mireckazimir/room-monitor/README.md

# Room monitoring shield for Raspberry Pi Zero
Part of Master's thesis "Multisensor Module for Raspberry Pi Zero"

### <ins>Hardware design</ins>
PCB designed in Altium designer

### <ins>Software implementation</ins>
