mireckazimir/room-monitor/hardware/readme.md

## Multi-sensor module for Raspberry Pi Zero
RPi Zero shield containg multiple sensors:
- MQ2 (SEN-17049)
- VEML7700
- SPH0645LM4H-B (2 pcs)
- EKMC1691111

PCB designed in Altium Designer
