mireckazimir/room-monitor/hardware/RPiZeroShield/readme.txt

Multisenzorový modul pro Raspberry Pi Zero
Bc. Miroslav Kažimír (xkazim00)

Adresár RPiZeroShield obsahuje projekt programu Altium Designer.
Hlavným súborom projektu je RPiZeroShield.PrjPcb, ktorý otvára celý projekt.

Súčasťou projektu je:
- schéma Sheet1.SchDoc,
- návrh dosky plošných spojov PCB1.PcbDoc,
- knižnica schematických značiek súčiastok RPiZeroShield.SCHLIB,
- knižnica modelov a pôdorysov súčiastok pre dosku plošných spojov PCB1.PcbLib,
- súbor slúžiaci na export podkladov Job1.OutJob
- a ďalšie obslužné súbory.

Podadresár "Project Outputs for RPiZeroShield" obsahuje výstupné podklady:
- montážne nákresy,
- súbory Gerber,
- súbory NC Drill,
- 3D model vo formáte PDF,
- súbory pre strojové osadenie súčiastok Pick Place,
- schémy vo formáte PDF,
- zoznam použitých súčiastok (bill of materials - BOM),
- a ďalšie výstupné súbory.
