mireckazimir/room-monitor/hardware/RPiZeroShield/BOM_RPiZeroShield.xlsx

Sheet: BOM list
Poloha | I2C ADDR (7-bit) | Označenie | Súčiastka (Mfr. no.) | Model | LIB | Link | Mouser no. | Poznámka
Raspberry Pi Zero Shield
MIC | - | MIC1, MIC2 | SPH0645LM4H-B |  |  | https://www.mouser.sk/ProductDetail/Knowles/SPH0645LM4H-B?qs=vWxAESdW%252B03xAMCR63JEHA%3D%3D | 721-SPH0645LM4H-B
MIC |  | R1,R2,R3,R4 | ERJ-6ENF51R0V |  |  | https://www.mouser.sk/ProductDetail/Panasonic/ERJ-6ENF51R0V?qs=sGAEpiMZZMtlubZbdhIBIGigBIB3A6R9PKWYQsW5ZXE%3D | 667-ERJ-6ENF51R0V
MIC |  | C1, C2 | C1206C201F4HACTU |  |  | https://www.mouser.sk/ProductDetail/KEMET/C1206C201F4HACTU | 80-C1206C201F4HACTU
MIC, PIR, LIGHT, ADC |  | C3, C4, C5, C7, C9 | GRM3195C1H104GA05D |  |  | https://www.mouser.sk/ProductDetail/Murata-Electronics/GRM3195C1H104GA05D?qs=F5EMLAvA7ICo6gyPKpY%252BBA%3D%3D | 81-GRM3195C1H104GA5D
PIR | - | U1 | EKMC1609111 |  |  | https://www.mouser.sk/ProductDetail/Panasonic-Industrial-Devices/EKMC1609111?qs=zW32dvEIR3uDXIrRofIryw%3D%3D | 769-EKMC1609111 | V schéme je EKMC1603111 - footprint totožný s EKMC1609111, iba 3D model sa jemne líši
PIR |  | C6 | ECE-A0JKS101B | EPW |  | https://www.mouser.sk/ProductDetail/Panasonic/ECE-A0JKS101B | 667-ECE-A0JKS101B
PIR |  | R5 | RC1206FR-07100KL |  |  | https://www.mouser.sk/ProductDetail/YAGEO/RC1206FR-07100KL?qs=sGAEpiMZZMtlubZbdhIBINNnCgAqWV6vON6Wzl3HpWU%3D | 603-RC1206FR-07100KL | Pull-down (možno ani nebude potrebné ho osádzať)
GAS SENSOR | - | U2 | SEN-17049 |  |  | https://www.mouser.sk/ProductDetail/SparkFun/SEN-17049 | 474-SEN-17049 | MQ2 senzor
GAS SENSOR |  | R6 | RCC12064K70FKEA |  |  | https://www.mouser.sk/ProductDetail/Vishay-Dale/RCC12064K70FKEA?qs=IS%252B4QmGtzzqZHWR9BmF4GA%3D%3D | 71-RCC12064K70FKEA | R LOAD - podľa dokumentácie 4.7kOhm, pre prípad dávam väčší rozmer, aby bola možná výmena za rezistor s väčším odporom
GAS SENSOR |  | R7 | RC1206JR-7W2RL |  |  | https://www.mouser.sk/ProductDetail/YAGEO/RC1206JR-7W2RL?qs=tggtontpCXN8n0ANSq4Tow%3D%3D | 603-RC1206JR-7W2RL | R Heater
LIGHT SENSOR | 0010000 = 0x10 | U3 | VEML7700-TT | EPW |  | https://www.mouser.sk/ProductDetail/Vishay-Semiconductors/VEML7700-TT?qs=BcfjnG7NVaXdL6DJFdWbdw%3D%3D | 78-VEML7700-TT
I2C_LLC |  | U4 | PCA9306D,118 | EPW |  | https://www.mouser.sk/ProductDetail/NXP-Semiconductors/PCA9306D118?qs=LOCUfHb8d9tHesUGaH1D9A%3D%3D | 771-PCA9306D-T | Alternatíva: PCA9306DP,118
I2C_LLC |  | R8 | RCC1206200KFKEA | EPW |  | https://www.mouser.sk/ProductDetail/Vishay-Dale/RCC1206200KFKEA?qs=IS%252B4QmGtzzrN0pIOKXDpaA%3D%3D | 71-RCC1206200KFKEA
I2C_LLC |  | C8 | C0805C101F3HACTU |  |  | https://www.mouser.sk/ProductDetail/KEMET/C0805C101F3HACTU?qs=W0yvOO0ixfH%2FhL0iFC0bAg%3D%3D | 80-C0805C101F3HACTU
I2C_LLC |  | R9, R10, R11, R12 | RCC12062K20FKEA | EPW |  | https://www.mouser.sk/ProductDetail/Vishay-Dale/RCC12062K20FKEA | 71-RCC12062K20FKEA | 2.2k pull-up pre 5V + rezerva (R9, R10) pre 3.3V pre prípad použitia s inou doskou ako RPI
ADC | 1101001 = 0x69 | U5 | MCP3422A1-E/SN |  |  | https://www.mouser.sk/ProductDetail/Microchip-Technology/MCP3422A1-E-SN?qs=X98pPdo4MrvGixh6%2F80sIQ%3D%3D | 579-MCP3422A1-E/SN
ADC |  | C10 | T491A106K020AT |  |  | https://www.mouser.sk/ProductDetail/KEMET/T491A106K020AT?qs=sGAEpiMZZMtZ1n0r9vR22fi4xnbQCvTobjhiqE69rJs%3D | 80-T491A106K020AT | 10uF tantalum CAP
ADC |  | R13, R14 | ERJ-P06D6801V | EPW |  | https://www.mouser.sk/ProductDetail/Panasonic/ERJ-P06D6801V?qs=sGAEpiMZZMtlubZbdhIBIHf7nJ0gOzH3WYsUgpuEB4E%3D | 667-ERJ-P06D6801V | voltage divider
ADC, GPIO LEVEL SHIFT |  | R15, R16, R17, R18 | ERJ-P08D1002V | EPW |  | https://www.mouser.sk/ProductDetail/Panasonic/ERJ-P08D1002V | 667-ERJ-P08D1002V | voltage divider, GPIO level shift
GPIO LEVEL SHIFT |  | Q1 | BSS138W-7-F |  |  | https://www.mouser.sk/ProductDetail/Diodes-Incorporated/BSS138W-7-F?qs=5zGBC69kmp6%2FnOvJMzpLyg%3D%3D | 621-BSS138W-F | Majú na TME, Mouser bude mať až 4.5.2022
GPIOS |  | P1 | 61304021821 |  |  | https://www.mouser.sk/ProductDetail/Wurth-Elektronik/61304021821?qs=bZr6mbWTK5mzEvTTGhcEyQ%3D%3D | 710-61304021821 | header 20x2 2.54
GPIOS |  | P2 | 22-05-2041 |  |  | https://www.mouser.sk/ProductDetail/Molex/22-05-2041?qs=th8CuLdcYnm2EBoucF1RsA%3D%3D | 538-22-05-2041 | header 4x1 2.54 right angle
GPIOS |  | P3 | M22-2010805 | EPW |  | https://www.mouser.sk/ProductDetail/Harwin/M22-2010805?qs=xxdqPuaJ%252Ba0KGJi9%2FnQIQA%3D%3D | 855-M22-2010805 | 2mm CC1101 M105
Ovládač
MCU |  | U1 | ESP32-WROOM-32E-N8 | EPW |  | https://www.mouser.sk/ProductDetail/Espressif-Systems/ESP32-WROOM-32E-N8 | 356-ESP32WRM32E164PH | Dostupné na TME, možná náhrada: ESP32-WROOM-32D-N16
MCU |  | C1 | GRM21BR61A226ME51L |  |  | https://www.mouser.sk/ProductDetail/Murata-Electronics/GRM21BR61A226ME51L?qs=GJ9CiehniqLndbYAzpHGvw%3D%3D | 81-GRM21BR61A226ME1L
MCU, BUTTONS, USB-UART |  | C2, C3, C4, C5, C7 | C0805C104K5RAC7411 |  |  | https://www.mouser.sk/ProductDetail/KEMET/C0805C104K5RAC7411?qs=jbRM9o5BbzPcVXF0wW9AYg%3D%3D | 80-C0805C104K5RACLR
MCU, USB-UART |  | R1, R5, R6 | ERJ-UP6J103V | EPW |  | https://www.mouser.sk/ProductDetail/Panasonic/ERJ-UP6J103V?qs=sGAEpiMZZMtlubZbdhIBIHDMOEdbf09NLiwDLtvIKYs%3D | 667-ERJ-UP6J103V
MCU CONTROL BUTTONS |  | RST, BOOT | SKRKAHE020 | EPW |  | https://www.mouser.sk/ProductDetail/Alps-Alpine/SKRKAHE020?qs=chTDxNqvsymUfAVYmcFXaw%3D%3D | 688-SKRKAHE010
USB TO UART |  | U2 | CP2102N-A02-GQFN28R |  |  | https://www.mouser.sk/ProductDetail/Silicon-Labs/CP2102N-A02-GQFN28R?qs=u16ybLDytRag4qKvSH3fTw%3D%3D | 634-CP2102NA02QFN28R
USB TO UART |  | J1 | 10104110-0001LF | EPW |  | https://www.mouser.sk/ProductDetail/Amphenol-FCI/10104110-0001LF?qs=3wMSRtz0%252BRoQF1VV4tle7w%3D%3D | 649-10104110-0001LF
USB TO UART |  | U3 | RCLAMP0502A.TCT | EPW |  | https://www.mouser.sk/ProductDetail/Semtech/RCLAMP0502A.TCT?qs=rBWM4%252BvDhIdDhGpW4CRdDg%3D%3D | 947-RCLAMP0502A.TCT | ESD
USB TO UART |  | alternatíva U3 | SP0503BAHTG |  |  | https://www.mouser.sk/ProductDetail/Littelfuse/SP0503BAHTG?qs=uD%2FdkN7XIa0NTYXwHdELYA%3D%3D
USB TO UART |  | D1 | BAT760-7 | EPW |  | https://www.mouser.sk/ProductDetail/Diodes-Incorporated/BAT760-7?qs=JV7lzlMm3yKDDyO09xoRbQ%3D%3D | 621-BAT760-7 | Možná náhrada: BAT760,115 (kompatibilná veľkosť)
USB TO UART |  | C6 | GRM21BR71C475KE51L |  |  | https://www.mouser.sk/ProductDetail/Murata-Electronics/GRM21BR71C475KE51L | 81-GRM21BR71C475KE1L
USB TO UART |  | R2 | ERJ-P06F2212V | EPW |  | https://www.mouser.sk/ProductDetail/Panasonic/ERJ-P06F2212V?qs=sGAEpiMZZMtlubZbdhIBIK7FbVYKWV6W4djmPI0bd1I%3D | 667-ERJ-P06F2212V
USB TO UART |  | R3 | ERJ-P06F4752V | EPW |  | https://www.mouser.sk/ProductDetail/Panasonic/ERJ-P06F4752V?qs=sGAEpiMZZMtlubZbdhIBIK7FbVYKWV6WQIiiDUYTQug%3D | 667-ERJ-P06F4752V
USB TO UART |  | R4 | ERJ-UP6J202V | ↑ |  | https://www.mouser.sk/ProductDetail/Panasonic/ERJ-UP6J202V | 667-ERJ-UP6J202V
USB TO UART |  | Q1, Q2 | MMSS8050-H-TP |  |  | https://www.mouser.sk/ProductDetail/Micro-Commercial-Components-MCC/MMSS8050-H-TP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 | 833-MMSS8050-H-TP | Má TME: https://www.tme.eu/sk/details/mmss8050-h-tp/tranzistory-npn-smd/micro-commercial-components/
5V TO 3V3 |  | U5 | TPS76733QPWPRQ1 |  |  | https://www.mouser.sk/ProductDetail/Texas-Instruments/TPS76733QPWPRQ1?qs=kujVBWBDkXJf0%2FNMBQXi3w%3D%3D | 595-TPS76733QPWPRQ1
5V TO 3V3 |  | C17 | C0805C473K5RACAUTO |  |  | https://www.mouser.sk/ProductDetail/KEMET/C0805C473K5RACAUTO?qs=Eba5AOZj%252BtuxVhONlLxsGA%3D%3D | 80-C0805C473K5RAUTO
5V TO 3V3 |  | R12 | ERJ-6ENF2493V |  |  | https://www.mouser.sk/ProductDetail/Panasonic/ERJ-6ENF2493V?qs=50QC8w71jAsBXHSBhQ2h%252Bg%3D%3D | 667-ERJ-6ENF2493V
5V TO 3V3 |  | C18 | T495A156K010ATE1K0 | EPW |  | https://www.mouser.sk/ProductDetail/KEMET/T495A156K010ATE1K0?qs=2nXowFelj8RMbRhnr1hrIw%3D%3D | 80-T495A156K10ATE1K0
GPIOS |  | J2 | M22-2510346 | EPW |  | https://www.mouser.sk/ProductDetail/Harwin/M22-2510346?qs=xxdqPuaJ%252Ba2KjCdxx8Eg9A%3D%3D | 855-M22-2510346 | výber medzi napájaním z USB alebo z 24V zdroja
GPIOS - pôvodná verzia |  | P1, P2 | 929974-01-13-RK | EPW |  | https://www.mouser.sk/ProductDetail/3M-Electronic-Solutions-Division/929974-01-13-RK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 | 517-929974-01-13-RK
GPIOS - pôvodná verzia |  | P3, P4, P5 | M20-9770446 | EPW |  | https://www.mouser.sk/ProductDetail/Harwin/M20-9770446?qs=ulE8k0yEMYbCPpMPHeYh4w%3D%3D | 855-M20-9770446
GPIOS |  | P1, P2 | SSQ-108-03-G-D | samtec |  | https://www.mouser.sk/ProductDetail/Samtec/SSQ-108-03-G-D?qs=rU5fayqh%252BE0RwWDEJ6pPUQ%3D%3D | 200-SSQ10803GD
(EXT.) JUMPER / SHUNT |  | - | 2SN-BK-G |  |  | https://www.mouser.sk/ProductDetail/Samtec/2SN-BK-G?qs=NxGO64s6WXgXJTHMWuV9rw%3D%3D | 200-2SNBKG | 2mm pitch
Ovládač - 24V to 5V DC/DC converter
24V TO 5V |  | U1 | TPS54233D |  |  | https://www.mouser.sk/ProductDetail/Texas-Instruments/TPS54233D?qs=3WadRV20yGze%2FDTvv7tgcQ%3D%3D | 595-TPS54233D
24V TO 5V |  | C5 | C0805C822K4RACTU |  |  | https://www.mouser.sk/ProductDetail/KEMET/C0805C822K4RACTU?qs=4ODw1oVXSTMLCQdsgrhj6A%3D%3D | 80-C0805C822K4R
24V TO 5V |  | R4 | CR0805-FX-2212ELF | EPW |  | https://www.mouser.sk/ProductDetail/Bourns/CR0805-FX-2212ELF?qs=Woncl1%2FcWdiX%2FAvxbaRGvQ%3D%3D | 652-CR0805FX-2212ELF
24V TO 5V |  | C4 | C2012C0G1H272J060AA |  |  | https://www.mouser.sk/ProductDetail/TDK/C2012C0G1H272J060AA?qs=dfay7wIA1uFk2uWc0btecA%3D%3D | 810-C2012C0G1H272J-1
24V TO 5V |  | C3 | C0805C100J5GACTU |  |  | https://www.mouser.sk/ProductDetail/KEMET/C0805C100J5GACTU?qs=nxj9Bpd7lumc4YIny1qjLA%3D%3D | 80-C0805C100J5G
24V TO 5V |  | R2 | CR0805-FX-3572ELF |  |  | https://www.mouser.sk/ProductDetail/Bourns/CR0805-FX-3572ELF?qs=TYKCbaKwe1C7hi2GwJICBw%3D%3D | 652-CR0805FX-3572ELF
24V TO 5V |  | R1 | ERJ-6ENF1693V |  |  | https://www.mouser.sk/ProductDetail/Panasonic/ERJ-6ENF1693V?qs=JjxTDIFmKPT3B0pvSbNiDw%3D%3D | 667-ERJ-6ENF1693V
24V TO 5V |  | C1, C2 | C3225X7R1H106M250AC |  |  | https://www.mouser.sk/ProductDetail/TDK/C3225X7R1H106M250AC?qs=6JAMGB%252BEdkwY95l8JqNSnw%3D%3D | 810-C3225X7R1H106MAC
24V TO 5V |  | C6 | C0805C104K8RACTU |  |  | https://www.mouser.sk/ProductDetail/KEMET/C0805C104K8RACTU?qs=jbCUrP3sAgQ5jyCqBgnvEg%3D%3D | 80-C0805C104K8R
24V TO 5V |  | D1 | SS2PH10-M3/84A | EPW |  | https://www.mouser.sk/ProductDetail/Vishay-General-Semiconductor/SS2PH10-M3-84A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 | 625-SS2PH10-M3 | pôvodne SS26FL
24V TO 5V |  | L1 | SRR1260-470M | EPW |  | https://www.mouser.sk/ProductDetail/Bourns/SRR1260-470M?qs=uD%2FoUDWqfvTgmKMYAHWd1A%3D%3D | 652-SRR1260-470M
24V TO 5V |  | R5 | CR0805-FX-1022ELF | EPW |  | https://www.mouser.sk/ProductDetail/Bourns/CR0805-FX-1022ELF?qs=tknLyCMIRbPv5oJN14zD0w%3D%3D | 652-CR0805FX-1022ELF
24V TO 5V |  | R6 | CRCW08051K96FKEA |  |  | https://www.mouser.sk/ProductDetail/Vishay-Dale/CRCW08051K96FKEA?qs=1CkV0QOCgMpA%2F6GTgXIN%2Fg%3D%3D | 71-CRCW08051K96FKEA
24V TO 5V |  | C7, C8, C9 | C3216X5R1A686M160AC |  |  | https://www.mouser.sk/ProductDetail/TDK/C3216X5R1A686M160AC?qs=xLDY6iXSiQbSeulE%2F6IRjg%3D%3D | 810-C3216X5R1A686M1C
CONNECTION |  | J1 | 1729018 | EPW |  | https://www.mouser.sk/ProductDetail/Phoenix-Contact/1729018?qs=cq3Rj917t3kvawwx9wVa9g%3D%3D | 651-1729018
CONNECTION |  | P1, P2 | TSW-108-07-T-D | samtec |  | https://www.mouser.sk/ProductDetail/Samtec/TSW-108-07-T-D?qs=FESYatJ8odIEFD%2FhBFUXcA%3D%3D | 200-TSW10807TD
Ovládač - TOP (vrchná časť)
GPIOS - pôvodná verzia |  | P1, P2 | M20-9991346 | EPW |  | https://www.mouser.sk/ProductDetail/Harwin/M20-9991346?qs=%252Bk6%2F5FB6qrlJEM0YdkMksg%3D%3D | 855-M20-9991346
GPIOS |  | P1, P2 | SSQ-108-01-T-D | samtec |  | https://www.mouser.sk/ProductDetail/Samtec/SSQ-108-01-T-D?qs=rU5fayqh%252BE3zRJ1c1JB7Dw%3D%3D | 200-SSQ10801TD
GPIOS |  | P3 | M20-9770446 | EPW |  | https://www.mouser.sk/ProductDetail/Harwin/M20-9770446?qs=ulE8k0yEMYbCPpMPHeYh4w%3D%3D | 855-M20-9770446 | EXT PM2.5
GPIOS |  | P4 | M22-2010805 | EPW |  | https://www.mouser.sk/ProductDetail/Harwin/M22-2010805?qs=xxdqPuaJ%252Ba0KGJi9%2FnQIQA%3D%3D | 855-M22-2010805 | 2mm CC1101 M105
CO2 SENSOR |  | U1 | SCD40-D-R2 | EPW |  | https://www.mouser.sk/ProductDetail/Sensirion/SCD40-D-R2?qs=HBWAp0VN4RjIKW%252BlMeZn1w%3D%3D | 403-SCD40-D-R2
I2C PULL-UP |  | R1, R2 | RCC12062K20FKEA |  |  | https://www.mouser.sk/ProductDetail/Vishay-Dale/RCC12062K20FKEA?qs=IS%252B4QmGtzzrW6O9X1hIPGg%3D%3D | 71-RCC12062K20FKEA | I2C pull-up
BUTTONS |  | SW1, SW3, SW3, SW4 | B3F-4000 |  |  | https://www.mouser.sk/ProductDetail/Omron-Electronics/B3F-4000?qs=B3tblJ0Nlt8c5sbFRctxww%3D%3D | 653-B3F-4000 | switch
BUTTONS |  | R3, R4, R5, R6 | ERJ-UP6J103V | EPW |  | https://www.mouser.sk/ProductDetail/Panasonic/ERJ-UP6J103V?qs=sGAEpiMZZMtlubZbdhIBIHDMOEdbf09NLiwDLtvIKYs%3D | 667-ERJ-UP6J103V | pull-up
BUTTONS |  | C1, C2, C3, C4 | C0805C104K5RAC7411 |  |  | https://www.mouser.sk/ProductDetail/KEMET/C0805C104K5RAC7411?qs=jbRM9o5BbzPcVXF0wW9AYg%3D%3D | 80-C0805C104K5RACLR | debouncing

Sheet: WallSwitch-TOP
Označenie | Súčiastka (Mfr. no.) | Link | Mouser no. | Poznámka
P1, P2 | SSQ-108-01-T-D | https://www.mouser.sk/ProductDetail/Samtec/SSQ-108-01-T-D?qs=rU5fayqh%252BE3zRJ1c1JB7Dw%3D%3D | 200-SSQ10801TD
P3 | M20-9770446 | https://www.mouser.sk/ProductDetail/Harwin/M20-9770446?qs=ulE8k0yEMYbCPpMPHeYh4w%3D%3D | 855-M20-9770446 | 4x1 2.54mm
P4 | M22-2010805 | https://www.mouser.sk/ProductDetail/Harwin/M22-2010805?qs=xxdqPuaJ%252Ba0KGJi9%2FnQIQA%3D%3D | 855-M22-2010805 | 8x1 2mm
U1 | SCD40-D-R2 | https://www.mouser.sk/ProductDetail/Sensirion/SCD40-D-R2?qs=HBWAp0VN4RjIKW%252BlMeZn1w%3D%3D | 403-SCD40-D-R2
R1, R2 | RCC12062K20FKEA | https://www.mouser.sk/ProductDetail/Vishay-Dale/RCC12062K20FKEA?qs=IS%252B4QmGtzzrW6O9X1hIPGg%3D%3D | 71-RCC12062K20FKEA
SW1, SW3, SW3, SW4 | B3F-4000 | https://www.mouser.sk/ProductDetail/Omron-Electronics/B3F-4000?qs=B3tblJ0Nlt8c5sbFRctxww%3D%3D | 653-B3F-4000
R3, R4, R5, R6 | ERJ-UP6J103V | https://www.mouser.sk/ProductDetail/Panasonic/ERJ-UP6J103V?qs=sGAEpiMZZMtlubZbdhIBIHDMOEdbf09NLiwDLtvIKYs%3D | 667-ERJ-UP6J103V
C1, C2, C3, C4 | C0805C104K5RAC7411 | https://www.mouser.sk/ProductDetail/KEMET/C0805C104K5RAC7411?qs=jbRM9o5BbzPcVXF0wW9AYg%3D%3D | 80-C0805C104K5RACLR

Sheet: WallSwitch-24VDCto5VDC
Označenie | Súčiastka (Mfr. no.) | Link | Mouser no. | Poznámka
U1 | TPS54233D | https://www.mouser.sk/ProductDetail/Texas-Instruments/TPS54233D?qs=3WadRV20yGze%2FDTvv7tgcQ%3D%3D | 595-TPS54233D
C5 | C0805C822K4RACTU | https://www.mouser.sk/ProductDetail/KEMET/C0805C822K4RACTU?qs=4ODw1oVXSTMLCQdsgrhj6A%3D%3D | 80-C0805C822K4R
R4 | CR0805-FX-2212ELF | https://www.mouser.sk/ProductDetail/Bourns/CR0805-FX-2212ELF?qs=Woncl1%2FcWdiX%2FAvxbaRGvQ%3D%3D | 652-CR0805FX-2212ELF
C4 | C2012C0G1H272J060AA | https://www.mouser.sk/ProductDetail/TDK/C2012C0G1H272J060AA?qs=dfay7wIA1uFk2uWc0btecA%3D%3D | 810-C2012C0G1H272J-1
C3 | C0805C100J5GACTU | https://www.mouser.sk/ProductDetail/KEMET/C0805C100J5GACTU?qs=nxj9Bpd7lumc4YIny1qjLA%3D%3D | 80-C0805C100J5G
R2 | CR0805-FX-3572ELF | https://www.mouser.sk/ProductDetail/Bourns/CR0805-FX-3572ELF?qs=TYKCbaKwe1C7hi2GwJICBw%3D%3D | 652-CR0805FX-3572ELF
R1 | ERJ-6ENF1693V | https://www.mouser.sk/ProductDetail/Panasonic/ERJ-6ENF1693V?qs=JjxTDIFmKPT3B0pvSbNiDw%3D%3D | 667-ERJ-6ENF1693V
C1, C2 | C3225X7R1H106M250AC | https://www.mouser.sk/ProductDetail/TDK/C3225X7R1H106M250AC?qs=6JAMGB%252BEdkwY95l8JqNSnw%3D%3D | 810-C3225X7R1H106MAC
C6 | C0805C104K8RACTU | https://www.mouser.sk/ProductDetail/KEMET/C0805C104K8RACTU?qs=jbCUrP3sAgQ5jyCqBgnvEg%3D%3D | 80-C0805C104K8R
D1 | SS2PH10-M3/84A | https://www.mouser.sk/ProductDetail/Vishay-General-Semiconductor/SS2PH10-M3-84A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 | 625-SS2PH10-M3 | pôvodne SS26FL
L1 | SRR1260-470M | https://www.mouser.sk/ProductDetail/Bourns/SRR1260-470M?qs=uD%2FoUDWqfvTgmKMYAHWd1A%3D%3D | 652-SRR1260-470M
R5 | CR0805-FX-1022ELF | https://www.mouser.sk/ProductDetail/Bourns/CR0805-FX-1022ELF?qs=tknLyCMIRbPv5oJN14zD0w%3D%3D | 652-CR0805FX-1022ELF
R6 | CRCW08051K96FKEA | https://www.mouser.sk/ProductDetail/Vishay-Dale/CRCW08051K96FKEA?qs=1CkV0QOCgMpA%2F6GTgXIN%2Fg%3D%3D | 71-CRCW08051K96FKEA
C7, C8, C9 | C3216X5R1A686M160AC | https://www.mouser.sk/ProductDetail/TDK/C3216X5R1A686M160AC?qs=xLDY6iXSiQbSeulE%2F6IRjg%3D%3D | 810-C3216X5R1A686M1C
J1 | 1729018 | https://www.mouser.sk/ProductDetail/Phoenix-Contact/1729018?qs=cq3Rj917t3kvawwx9wVa9g%3D%3D | 651-1729018
P1, P2 | TSW-108-07-T-D | https://www.mouser.sk/ProductDetail/Samtec/TSW-108-07-T-D?qs=FESYatJ8odIEFD%2FhBFUXcA%3D%3D | 200-TSW10807TD

Sheet: WallSwitch-Core
Označenie | Súčiastka (Mfr. no.) | Link | Mouser no. | Poznámka
U1 | ESP32-WROOM-32E-N8 | https://www.mouser.sk/ProductDetail/Espressif-Systems/ESP32-WROOM-32E-N8 | 356-ESP32WRM32E164PH | Dostupné na TME, možná náhrada: ESP32-WROOM-32D-N16
C1 | GRM21BR61A226ME51L | https://www.mouser.sk/ProductDetail/Murata-Electronics/GRM21BR61A226ME51L?qs=GJ9CiehniqLndbYAzpHGvw%3D%3D | 81-GRM21BR61A226ME1L
C2, C3, C4, C5, C7 | C0805C104K5RAC7411 | https://www.mouser.sk/ProductDetail/KEMET/C0805C104K5RAC7411?qs=jbRM9o5BbzPcVXF0wW9AYg%3D%3D | 80-C0805C104K5RACLR
R1, R5, R6 | ERJ-UP6J103V | https://www.mouser.sk/ProductDetail/Panasonic/ERJ-UP6J103V?qs=sGAEpiMZZMtlubZbdhIBIHDMOEdbf09NLiwDLtvIKYs%3D | 667-ERJ-UP6J103V
RST, BOOT | SKRKAHE020 | https://www.mouser.sk/ProductDetail/Alps-Alpine/SKRKAHE020?qs=chTDxNqvsymUfAVYmcFXaw%3D%3D | 688-SKRKAHE010
U2 | CP2102N-A02-GQFN28R | https://www.mouser.sk/ProductDetail/Silicon-Labs/CP2102N-A02-GQFN28R?qs=u16ybLDytRag4qKvSH3fTw%3D%3D | 634-CP2102NA02QFN28R
J1 | 10104110-0001LF | https://www.mouser.sk/ProductDetail/Amphenol-FCI/10104110-0001LF?qs=3wMSRtz0%252BRoQF1VV4tle7w%3D%3D | 649-10104110-0001LF
U3 | RCLAMP0502A.TCT | https://www.mouser.sk/ProductDetail/Semtech/RCLAMP0502A.TCT?qs=rBWM4%252BvDhIdDhGpW4CRdDg%3D%3D | 947-RCLAMP0502A.TCT | ESD
alternatíva U3 | SP0503BAHTG | https://www.mouser.sk/ProductDetail/Littelfuse/SP0503BAHTG?qs=uD%2FdkN7XIa0NTYXwHdELYA%3D%3D
D1 | BAT760-7 | https://www.mouser.sk/ProductDetail/Diodes-Incorporated/BAT760-7?qs=JV7lzlMm3yKDDyO09xoRbQ%3D%3D | 621-BAT760-7 | Možná náhrada: BAT760,115 (kompatibilná veľkosť)
C6 | GRM21BR71C475KE51L | https://www.mouser.sk/ProductDetail/Murata-Electronics/GRM21BR71C475KE51L | 81-GRM21BR71C475KE1L
R2 | ERJ-P06F2212V | https://www.mouser.sk/ProductDetail/Panasonic/ERJ-P06F2212V?qs=sGAEpiMZZMtlubZbdhIBIK7FbVYKWV6W4djmPI0bd1I%3D | 667-ERJ-P06F2212V
R3 | ERJ-P06F4752V | https://www.mouser.sk/ProductDetail/Panasonic/ERJ-P06F4752V?qs=sGAEpiMZZMtlubZbdhIBIK7FbVYKWV6WQIiiDUYTQug%3D | 667-ERJ-P06F4752V
R4 | ERJ-UP6J202V | https://www.mouser.sk/ProductDetail/Panasonic/ERJ-UP6J202V | 667-ERJ-UP6J202V
Q1, Q2 | MMSS8050-H-TP | https://www.mouser.sk/ProductDetail/Micro-Commercial-Components-MCC/MMSS8050-H-TP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 | 833-MMSS8050-H-TP | Má TME: https://www.tme.eu/sk/details/mmss8050-h-tp/tranzistory-npn-smd/micro-commercial-components/
U5 | TPS76733QPWPRQ1 | https://www.mouser.sk/ProductDetail/Texas-Instruments/TPS76733QPWPRQ1?qs=kujVBWBDkXJf0%2FNMBQXi3w%3D%3D | 595-TPS76733QPWPRQ1
C17 | C0805C473K5RACAUTO | https://www.mouser.sk/ProductDetail/KEMET/C0805C473K5RACAUTO?qs=Eba5AOZj%252BtuxVhONlLxsGA%3D%3D | 80-C0805C473K5RAUTO
R12 | ERJ-6ENF2493V | https://www.mouser.sk/ProductDetail/Panasonic/ERJ-6ENF2493V?qs=50QC8w71jAsBXHSBhQ2h%252Bg%3D%3D | 667-ERJ-6ENF2493V
C18 | T495A156K010ATE1K0 | https://www.mouser.sk/ProductDetail/KEMET/T495A156K010ATE1K0?qs=2nXowFelj8RMbRhnr1hrIw%3D%3D | 80-T495A156K10ATE1K0
J2 | M22-2510346 | https://www.mouser.sk/ProductDetail/Harwin/M22-2510346?qs=xxdqPuaJ%252Ba2KjCdxx8Eg9A%3D%3D | 855-M22-2510346 | výber medzi napájaním z USB alebo z 24V zdroja
P1, P2 | SSQ-108-03-G-D | https://www.mouser.sk/ProductDetail/Samtec/SSQ-108-03-G-D?qs=rU5fayqh%252BE0RwWDEJ6pPUQ%3D%3D | 200-SSQ10803GD
- | 2SN-BK-G | https://www.mouser.sk/ProductDetail/Samtec/2SN-BK-G?qs=NxGO64s6WXgXJTHMWuV9rw%3D%3D | 200-2SNBKG | 2mm pitch

Sheet: RPiShield
Označenie | Súčiastka (Mfr. no.) | Link | Mouser no. | Poznámka
MIC1, MIC2 | SPH0645LM4H-B | https://www.mouser.sk/ProductDetail/Knowles/SPH0645LM4H-B?qs=vWxAESdW%252B03xAMCR63JEHA%3D%3D | 721-SPH0645LM4H-B
R1,R2,R3,R4 | ERJ-6ENF51R0V | https://www.mouser.sk/ProductDetail/Panasonic/ERJ-6ENF51R0V?qs=sGAEpiMZZMtlubZbdhIBIGigBIB3A6R9PKWYQsW5ZXE%3D | 667-ERJ-6ENF51R0V
C1, C2 | C1206C201F4HACTU | https://www.mouser.sk/ProductDetail/KEMET/C1206C201F4HACTU | 80-C1206C201F4HACTU
C3, C4, C5, C7, C9 | GRM3195C1H104GA05D | https://www.mouser.sk/ProductDetail/Murata-Electronics/GRM3195C1H104GA05D?qs=F5EMLAvA7ICo6gyPKpY%252BBA%3D%3D | 81-GRM3195C1H104GA5D
U1 | EKMC1609111 | https://www.mouser.sk/ProductDetail/Panasonic-Industrial-Devices/EKMC1609111?qs=zW32dvEIR3uDXIrRofIryw%3D%3D | 769-EKMC1609111 | V schéme je EKMC1603111 - footprint totožný s EKMC1609111, iba 3D model sa jemne líši
C6 | ECE-A0JKS101B | https://www.mouser.sk/ProductDetail/Panasonic/ECE-A0JKS101B | 667-ECE-A0JKS101B
R5 | RC1206FR-07100KL | https://www.mouser.sk/ProductDetail/YAGEO/RC1206FR-07100KL?qs=sGAEpiMZZMtlubZbdhIBINNnCgAqWV6vON6Wzl3HpWU%3D | 603-RC1206FR-07100KL | Pull-down (možno ani nebude potrebné ho osádzať)
U2 | SEN-17049 | https://www.mouser.sk/ProductDetail/SparkFun/SEN-17049 | 474-SEN-17049 | MQ2 senzor
R6 | RCC12064K70FKEA | https://www.mouser.sk/ProductDetail/Vishay-Dale/RCC12064K70FKEA?qs=IS%252B4QmGtzzqZHWR9BmF4GA%3D%3D | 71-RCC12064K70FKEA | R LOAD - podľa dokumentácie 4.7kOhm, pre prípad dávam väčší rozmer, aby bola možná výmena za rezistor s väčším odporom
R7 | RC1206JR-7W2RL | https://www.mouser.sk/ProductDetail/YAGEO/RC1206JR-7W2RL?qs=tggtontpCXN8n0ANSq4Tow%3D%3D | 603-RC1206JR-7W2RL | R Heater
U3 | VEML7700-TT | https://www.mouser.sk/ProductDetail/Vishay-Semiconductors/VEML7700-TT?qs=BcfjnG7NVaXdL6DJFdWbdw%3D%3D | 78-VEML7700-TT
U4 | PCA9306D,118 | https://www.mouser.sk/ProductDetail/NXP-Semiconductors/PCA9306D118?qs=LOCUfHb8d9tHesUGaH1D9A%3D%3D | 771-PCA9306D-T | Alternatíva: PCA9306DP,118
R8 | RCC1206200KFKEA | https://www.mouser.sk/ProductDetail/Vishay-Dale/RCC1206200KFKEA?qs=IS%252B4QmGtzzrN0pIOKXDpaA%3D%3D | 71-RCC1206200KFKEA
C8 | C0805C101F3HACTU | https://www.mouser.sk/ProductDetail/KEMET/C0805C101F3HACTU?qs=W0yvOO0ixfH%2FhL0iFC0bAg%3D%3D | 80-C0805C101F3HACTU
R9, R10, R11, R12 | RCC12062K20FKEA | https://www.mouser.sk/ProductDetail/Vishay-Dale/RCC12062K20FKEA | 71-RCC12062K20FKEA | 2.2k pull-up pre 5V + rezerva (R9, R10) pre 3.3V pre prípad použitia s inou doskou ako RPI
U5 | MCP3422A1-E/SN | https://www.mouser.sk/ProductDetail/Microchip-Technology/MCP3422A1-E-SN?qs=X98pPdo4MrvGixh6%2F80sIQ%3D%3D | 579-MCP3422A1-E/SN
C10 | T491A106K020AT | https://www.mouser.sk/ProductDetail/KEMET/T491A106K020AT?qs=sGAEpiMZZMtZ1n0r9vR22fi4xnbQCvTobjhiqE69rJs%3D | 80-T491A106K020AT | 10uF tantalum CAP
R13, R14 | ERJ-P06D6801V | https://www.mouser.sk/ProductDetail/Panasonic/ERJ-P06D6801V?qs=sGAEpiMZZMtlubZbdhIBIHf7nJ0gOzH3WYsUgpuEB4E%3D | 667-ERJ-P06D6801V | voltage divider
R15, R16, R17, R18 | ERJ-P08D1002V | https://www.mouser.sk/ProductDetail/Panasonic/ERJ-P08D1002V | 667-ERJ-P08D1002V | voltage divider, GPIO level shift
Q1 | BSS138W-7-F | https://www.mouser.sk/ProductDetail/Diodes-Incorporated/BSS138W-7-F?qs=5zGBC69kmp6%2FnOvJMzpLyg%3D%3D | 621-BSS138W-F | Majú na TME, Mouser bude mať až 4.5.2022
P1 | 61304021821 | https://www.mouser.sk/ProductDetail/Wurth-Elektronik/61304021821?qs=bZr6mbWTK5mzEvTTGhcEyQ%3D%3D | 710-61304021821 | header 20x2 2.54
P2 | 22-05-2041 | https://www.mouser.sk/ProductDetail/Molex/22-05-2041?qs=th8CuLdcYnm2EBoucF1RsA%3D%3D | 538-22-05-2041 | header 4x1 2.54 right angle
P3 | M22-2010805 | https://www.mouser.sk/ProductDetail/Harwin/M22-2010805?qs=xxdqPuaJ%252Ba0KGJi9%2FnQIQA%3D%3D | 855-M22-2010805 | 2mm CC1101 M105

Sheet: Mouser BOM
Nové označenie | Súčiastka (Mfr. no.) | Link | Mouser no. | Počet
