mireckazimir/room-monitor/hardware/RPiZeroShield/Project Outputs for RPiZeroShield/Schematics/RPiZeroShield.PDF

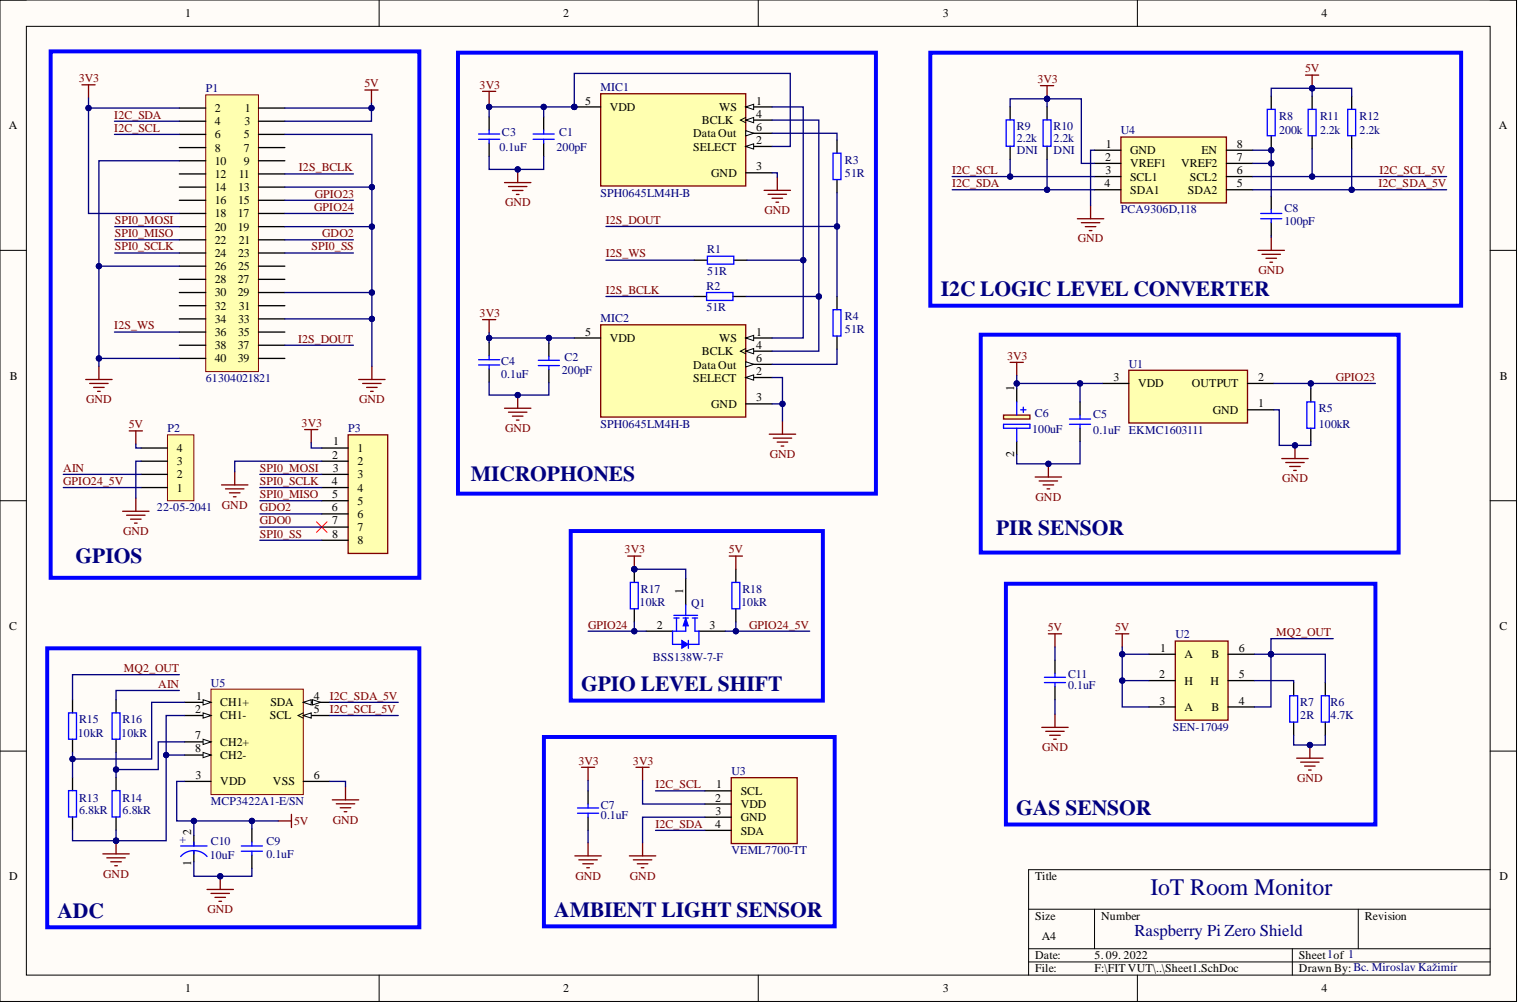
[picture p1: page 1]

Raspberry Pi Zero Shiel
