mireckazimir/room-monitor/hardware/RPiZeroShield/Project Outputs for RPiZeroShield/Assembly Drawings/RPiZeroShield.PDF

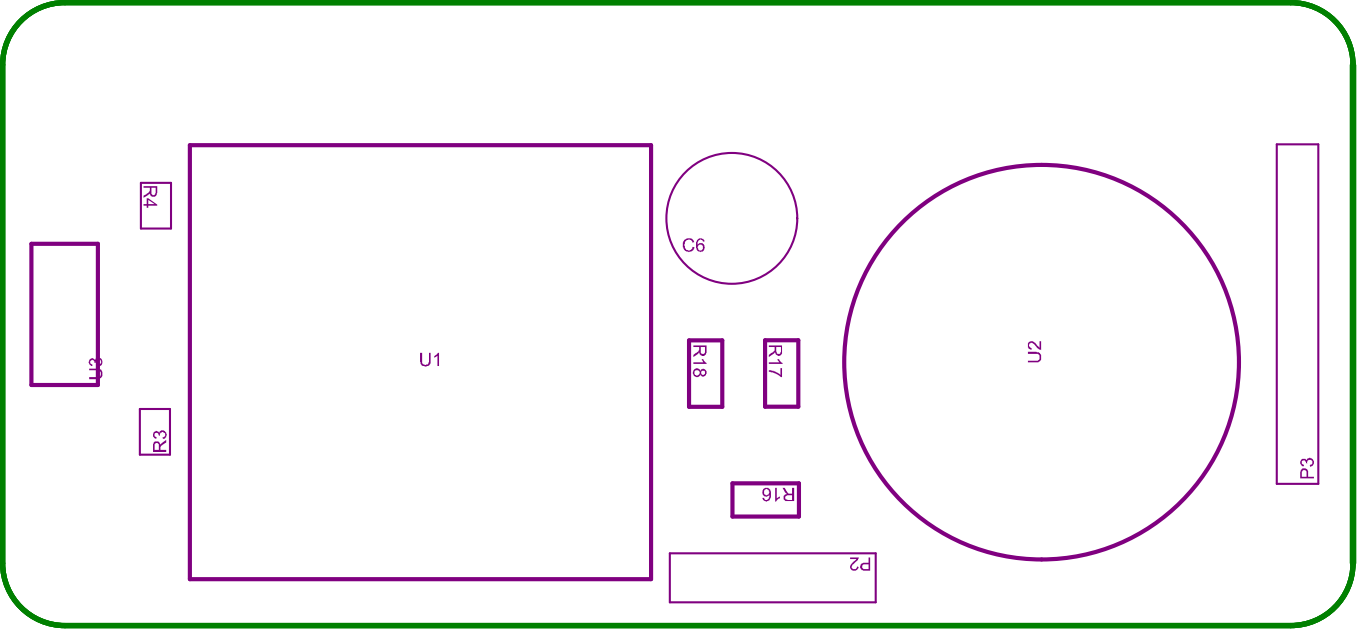
[picture p2: page 1]

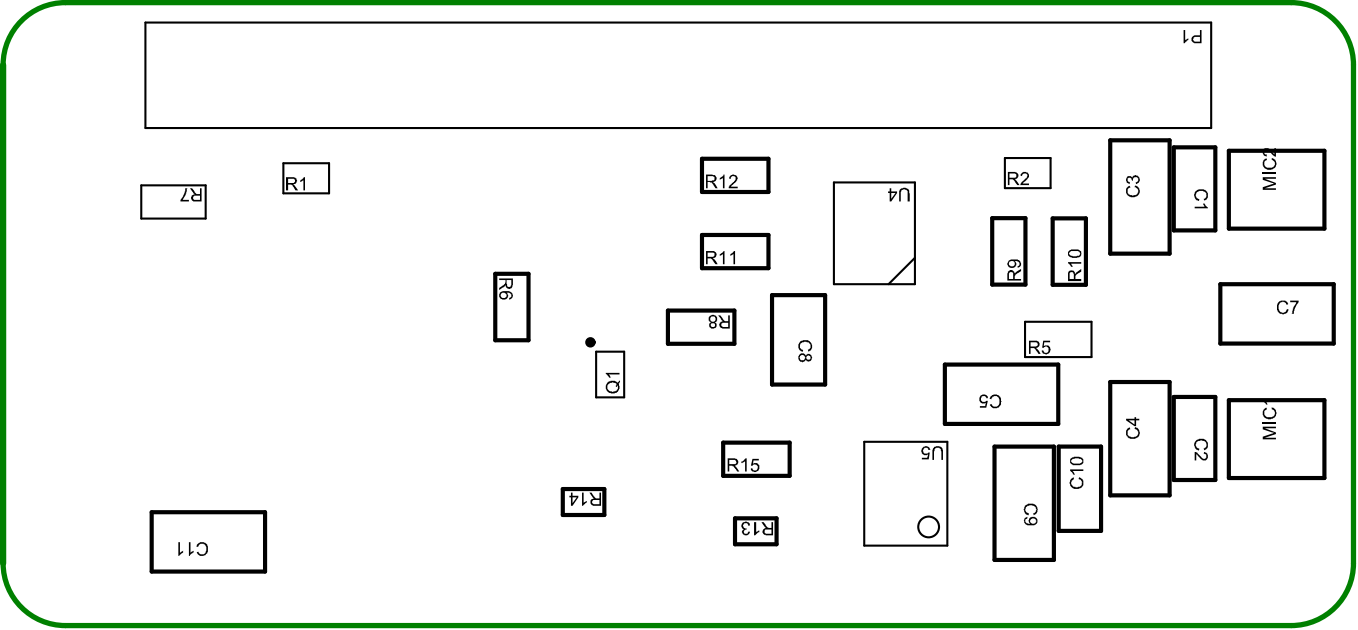
[picture p3: page 2]
