mireckazimir/room-monitor/(list of files, drawings)

Other design files:
hardware/RPiZeroShield/PCB1.PcbDoc
hardware/RPiZeroShield/PCB1.PcbLib
hardware/RPiZeroShield/RPiZeroShield.PrjPcb
hardware/RPiZeroShield/RPiZeroShield.SCHLIB
hardware/RPiZeroShield/Sheet1.SchDoc
